adafruit/Adafruit-MCP3421-18-Bit-ADC-PCB/Adafruit MCP3421 ADC.brd

## EAGLE design Adafruit MCP3421 ADC.brd (2023-12-21)

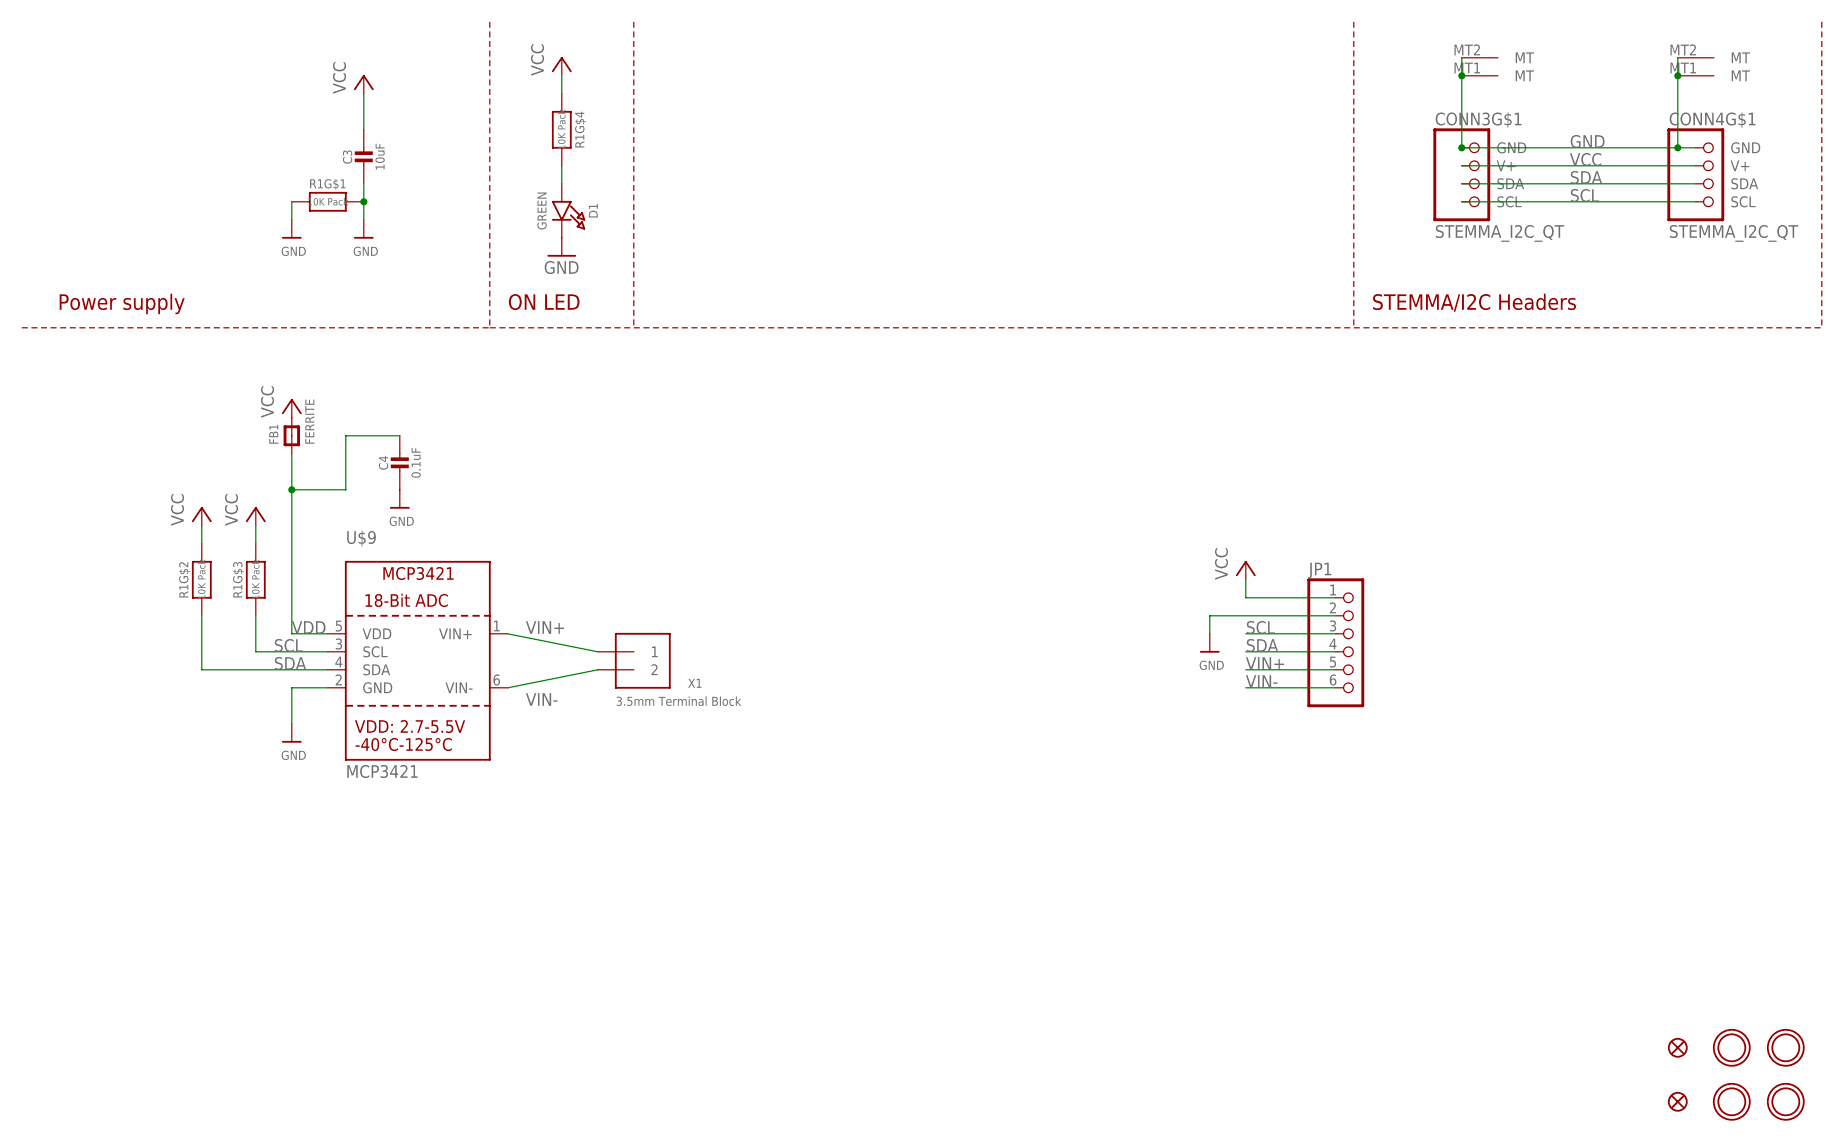
[picture p2: schematic Adafruit MCP3421 ADC.sch]

Parts:
C3: 10uF; 0805-NO
C4: 0.1uF; 0603-NO
CONN3, CONN4: STEMMA_I2C_QT; JST_SH4
D1: GREEN; CHIPLED_0603_NOOUTLINE
FB1: FERRITE; 0603-NO
FID3, FID4: FIDUCIAL_1MM
JP1: HEADER-1X670MIL; 1X06_ROUND_70
R1: 10K Pack; RESPACK_4X0603
U$9: MCP3421; SOT23-6
U$20, U$21, U$25, U$27: MOUNTINGHOLE2.5; MOUNTINGHOLE_2.5_PLATED
X1: 3.5mm Terminal Block; TERMBLOCK_1X2-3.5MM

Connections:
GND: C3.2, C4.2, CONN3.1 (GND), CONN3.MT1 (MT), CONN3.MT2 (MT), CONN4.1 (GND), CONN4.MT1 (MT), CONN4.MT2 (MT), D1.C, JP1.2, R1.1, R1.8 (2), U$9.2 (GND)
unnamed: D1.A, R1.5 (2)
SCL: CONN3.4 (SCL), CONN4.4 (SCL), JP1.3, R1.3 (1), U$9.3 (SCL)
SDA: CONN3.3 (SDA), CONN4.3 (SDA), JP1.4, R1.2 (1), U$9.4 (SDA)
VCC: C3.1, CONN3.2 (V+), CONN4.2 (V+), FB1.2, JP1.1, R1.4 (1), R1.6 (2), R1.7 (2)
VDD: C4.1, FB1.1, U$9.5 (VDD)
VIN+: JP1.5, U$9.1 (VIN+), X1.1
VIN-: JP1.6, U$9.6 (VIN-), X1.2

Notes on the sheet:
STEMMA/I2C Headers
ON LED
Power supply

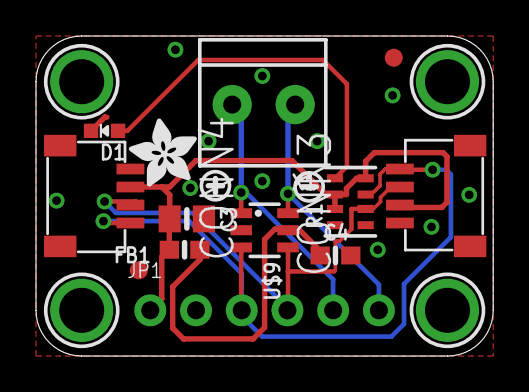
[picture p3: board Adafruit MCP3421 ADC.brd from above]

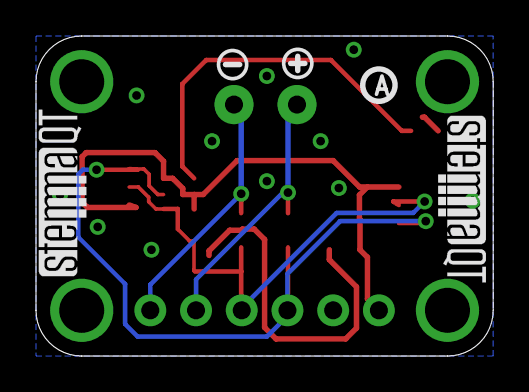
[picture p4: board Adafruit MCP3421 ADC.brd from below]

Board: 2 copper layers, 25.4 x 17.8 mm, 37 parts (9 on the bottom side), 8 nets.

Other parts of the board:
PLABEL0: PLABEL0
PLABEL1: PLABEL1
PLABEL2: PLABEL2
PLABEL3: PLABEL3
PLABEL4: PLABEL4
PLABEL5: PLABEL5
PLABEL6: PLABEL6
PLABEL7: PLABEL7
PLABEL8: PLABEL8
PLABEL9: PLABEL9
PLABEL10: PLABEL10
PLABEL11: PLABEL11
PLABEL12: PLABEL12
U$2, U$7: SYMBOL_PLUS
U$4, U$5: SYMBOL_MINUS
U$8: PCBFEAT-REV-040
U$29: ADAFRUIT_3.5MM
U$31, U$32: STEMMAQT
